abliveira/Caminho-Livre/hardware/prod/Desenho Luva da Bengala - Caminho Livre.pdf

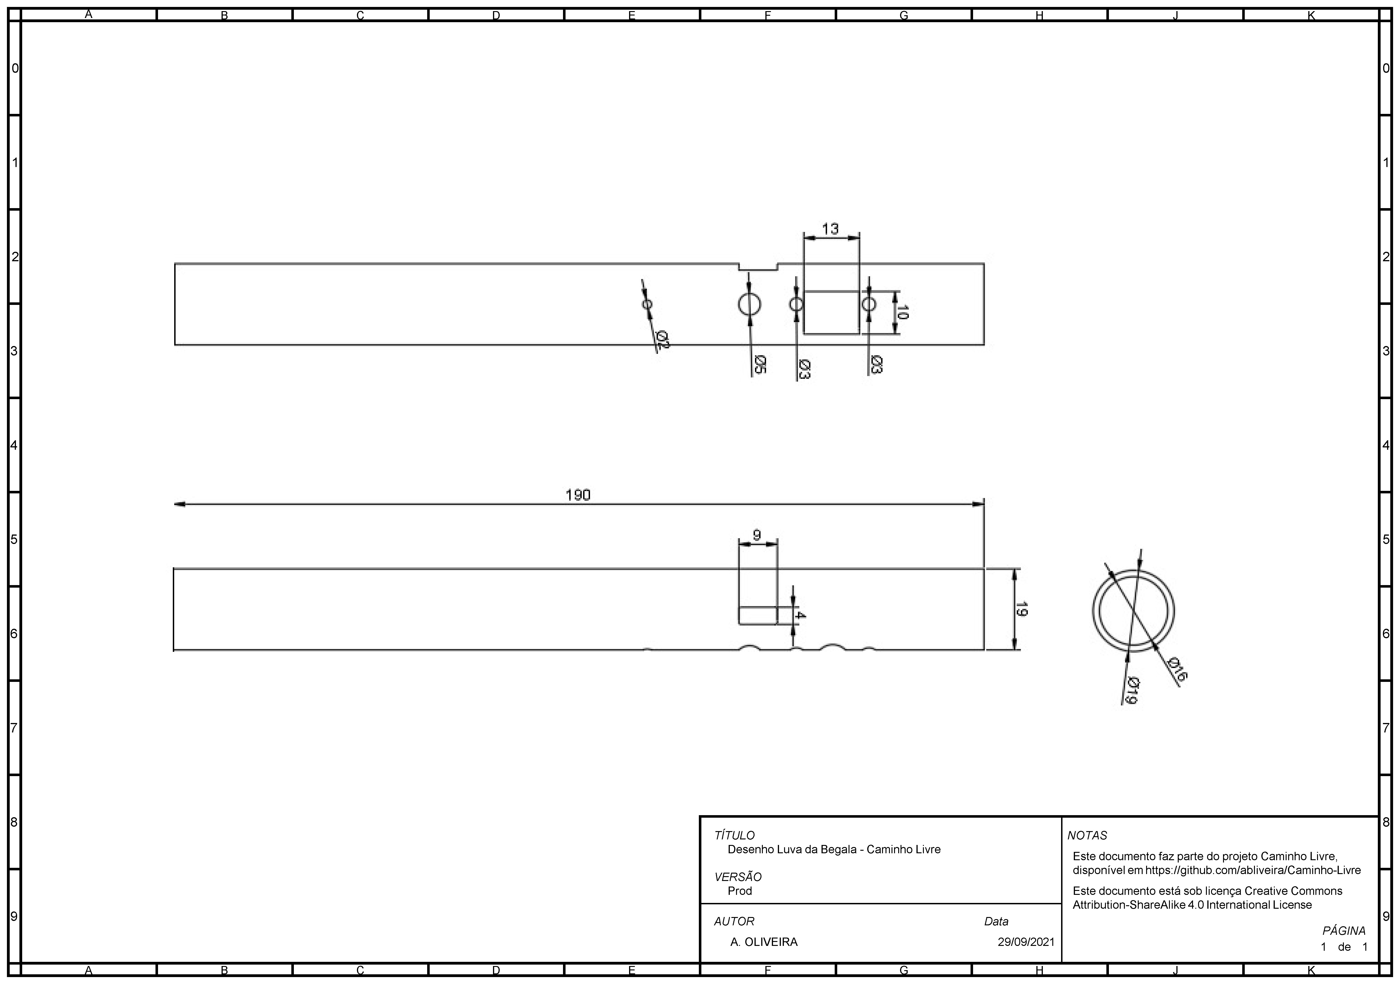
[picture p6: page 1]
