abliveira/Caminho-Livre/hardware/prod/Desenho Placa de Controle - Caminho Livre.pdf

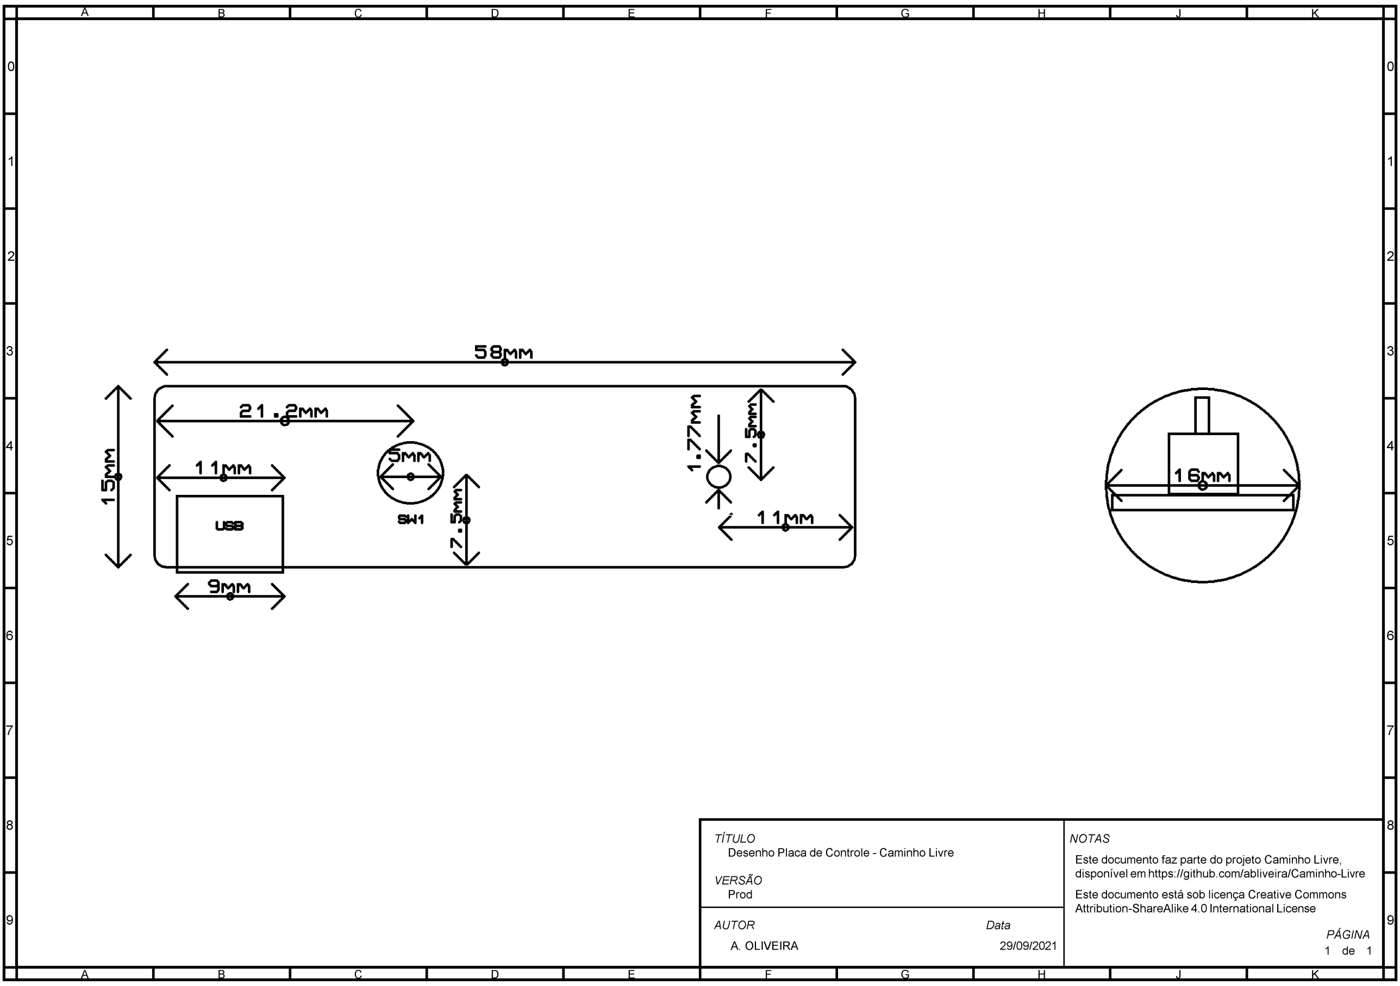
[picture p7: page 1]
