abliveira/Caminho-Livre/hardware/prod/BOM Placa de Controle (M328P) - Caminho Livre.xls

Bill Of Materials for Placa de Controle (M328P) - Caminho Livre
Design Title | Placa de Controle (M328P) - Caminho Livre
Author | A. OLIVEIRA
Version | Prod
Design Last Modified | 2021-10-12
Total Parts In Design | 36
Este documento faz parte do projeto Caminho Livre, disponível em https://github.com/abliveira/Caminho-Livre
Este documento está sob licença Creative Commons Attribution-ShareAlike 4.0 International License
Category | References | Quantity | Value | Description | PCB Package
Capacitor | C1-C2,C6 | 3 | 0.1u | Ceramic Capacitor 0.1uF 16V 0805 (2012 metric) | CAPC2012X100
Capacitor | C3,C5 | 2 | 10u | Tantalum Capacitor 10uF 10V 0805 (2012 metric) | CAPC2012X100
Capacitor | C4 | 1 | 470pF | Ceramic Capacitor 470pF 10% 50V 0805 (2012 metric) | CAPC2012X100
Capacitor | C8 | 1 | 2.2u | Ceramic Capacitor 2.2uF 16V 0805 (2012 metric) | CAPC2012X100
Connector | BAT,MOTOR,VUSB | 3 | CONN-SIL2 | 0.1in pitch SIL connector strip
Connector | ICSP | 1 | A2005HWV-2x3P | 6 Position 2 Row Header Connector 0.079" (2.00mm) Through Hole
Connector | SENSOR | 1 | CONN-SIL5 | 0.1in pitch SIL connector strip
Connector | SERIAL | 1 | CONN-SIL3 | 0.1in pitch SIL connector strip
Connector | USB | 1 | TYPE-C-31-M-17 | USB Type-C Female Connector 6pin
Diodes | D1 | 1 | 1N4148WX-TP | General Purpose Diode 75V 150mA SOD-323 | SOD2514X100
Integrated Circuit | U1 | 1 | TP4056 | SOP-8_EP_150mil Battery Management IC | SOIC127P600X175-8-HEATSINK
Integrated Circuit | U2 | 1 | DW01 | SOT-23-6 Battery Management IC | SOT95P280X135-6N
Integrated Circuit | U3 | 1 | FS8205 | Dual N-Channel SOT-23-6 MOSFET | SOT95P280X135-6N
Integrated Circuit | U4 | 1 | MIC5205-3.3YM5-TR | Low Dropout Regulator 3.3V 150mA SOT-23-5 | SOT-23-5_MC
Integrated Circuit | M328P | 1 | ATMEGA328P-AU | AVR series Microcontroller IC 8-Bit 20MHz 32KB (16K x 16) FLASH 32-TQFP (7x7) | QFP80P900X900X120-32
Miscellaneous | RV1 | 1 | VG039NCHXTB204 | ±25% 200kΩ SMD Variable Resistor
Miscellaneous | SW1 | 1 | K8-5851D-L1 | Pushbutton Switch DPDT Latching 100mA 5.8x5.8mm, TL2203EE Equivalent
Miscellaneous | X1 | 1 | CSTCE8M00G15C99-R0 | Ceramic Resonator 8MHz ±0.1% 33pF 40Ω SMD3213-3P | 3-SMD
Resistor | R1 | 1 | 2.20K | 2.20K OHM 1/8W 1% 0805 (2012 metric) SMD | RESC2012X50
Resistor | R2-R3,R6-R9,R11-R12 | 8 | 10K | 10K OHM 1/8W 1% 0805 (2012 metric) SMD | RESC2012X50
Resistor | R4,R10 | 2 | 1K | 1.0K OHM 1/8W 1% 0805 (2012 metric) SMD | RESC2012X50
Resistor | R5 | 1 | 100R | 100 OHM 1/8W 1% 0805 (2012 metric) SMD | RESC2012X50
Transistor | Q1 | 1 | HX2302A | 20V 2.5A 59mΩ 4.5V, 2.5A 900mW 1.2V 250μA N Channel SOT-23 MOSFET | SOT95P230X109-3
