abliveira/Caminho-Livre/(notices)

Notices in the files:
README.md:
CC BY-SA 4.0
